gberthou/talabardine/board/board.brd

## EAGLE design board/board.brd (2021-04-22)

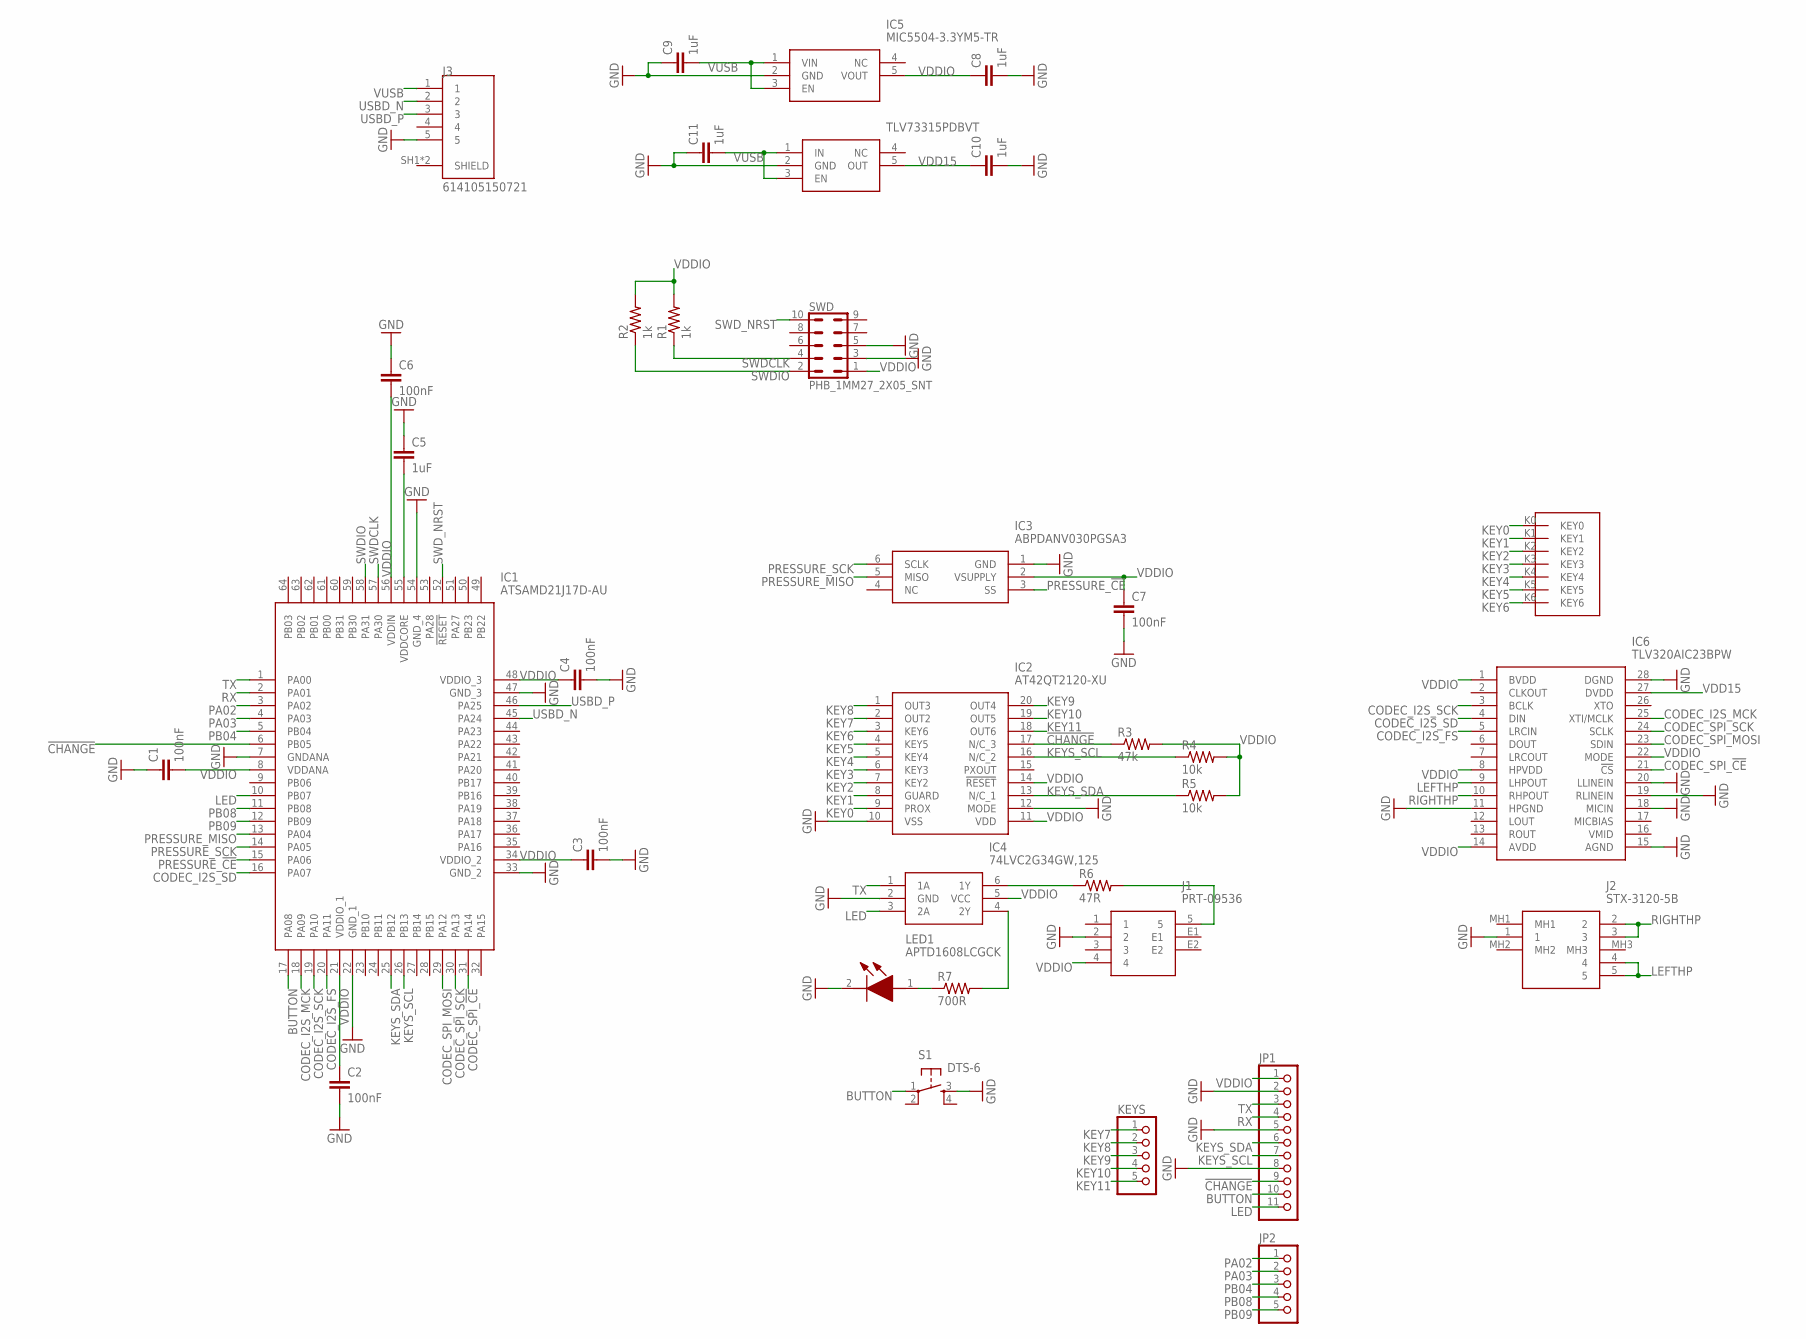
[picture p1: schematic board.sch]

Parts:
C1, C2, C3, C4, C6, C7: 100nF; C0603
C5, C8, C9, C10, C11: 1uF; C0603
IC1: ATSAMD21J17D-AU; QFP50P1200X1200X120-64N
IC2: AT42QT2120-XU; SOP65P638X120-20N
IC3: ABPDANV030PGSA3
IC4: 74LVC2G34GW,125; SOP65P210X110-6N
IC5: MIC5504-3.3YM5-TR; SOT95P280X145-5N
IC6: TLV320AIC23BPW; SOP65P640X120-28N
J1: PRT-09536; PRT09536
J2: STX-3120-5B; STX31205B
J3: 614105150721; WURTH_614105150721
JP1: PINHD-1X11; 1X11
JP2: PINHD-1X5; 1X05
KEYS: PINHD-1X5; 1X05
LED1: APTD1608LCGCK; APT1608CGCK
R1, R2: 1k; R0603
R3: 47k; R0603
R4, R5: 10k; R0603
R6: 47R; R0603
R7: 700R; R0603
S1: DTS-6
SWD: PHB_1MM27_2X05_SNT
TLV73315PDBVT: TLV73333PDBVT; SOT95P280X145-5N
U$1: KEYS

Connections:
!CHANGE!: IC1.6 (PB05), IC2.17 (N/C_3), JP1.9, R3.1
BUTTON: IC1.17 (PA08), JP1.10, S1.1
CODEC_I2S_FS: IC1.20 (PA11), IC6.5 (LRCIN)
CODEC_I2S_MCK: IC1.18 (PA09), IC6.25 (XTI/MCLK)
CODEC_I2S_SCK: IC1.19 (PA10), IC6.3 (BCLK)
CODEC_I2S_SD: IC1.16 (PA07), IC6.4 (DIN)
CODEC_SPI_!CE!: IC1.31 (PA14), IC6.21 (!CS)
CODEC_SPI_MOSI: IC1.29 (PA12), IC6.23 (SDIN)
CODEC_SPI_SCK: IC1.30 (PA13), IC6.24 (SCLK)
GND: C1.1, C2.2, C3.2, C4.2, C5.1, C6.1, C7.2, C8.2, C9.1, C10.2, C11.1, IC1.7 (GNDANA), IC1.22 (GND_1), IC1.33 (GND_2), IC1.47 (GND_3), IC1.54 (GND_4), IC2.10 (VSS), IC2.12 (MODE), IC3.1 (GND), IC4.2 (GND), IC5.2 (GND), IC6.11 (HPGND), IC6.15 (AGND), IC6.18 (MICIN), IC6.19 (RLINEIN), IC6.20 (LLINEIN), IC6.28 (DGND), J1.2, J2.1, J3.5, JP1.2, JP1.5, JP1.8, LED1.2 (K), S1.3, SWD.3, SWD.5, TLV73315PDBVT.2 (GND)
KEY0: IC2.9 (PROX), U$1.K0 (KEY0)
KEY1: IC2.8 (GUARD), U$1.K1 (KEY1)
KEY2: IC2.7 (KEY2), U$1.K2 (KEY2)
KEY3: IC2.6 (KEY3), U$1.K3 (KEY3)
KEY4: IC2.5 (KEY4), U$1.K4 (KEY4)
KEY5: IC2.4 (KEY5), U$1.K5 (KEY5)
KEY6: IC2.3 (KEY6), U$1.K6 (KEY6)
KEY7: IC2.2 (OUT2), KEYS.1
KEY8: IC2.1 (OUT3), KEYS.2
KEY9: IC2.20 (OUT4), KEYS.3
KEY10: IC2.19 (OUT5), KEYS.4
KEY11: IC2.18 (OUT6), KEYS.5
KEYS_SCL: IC1.26 (PB13), IC2.16 (N/C_2), JP1.7, R4.1
KEYS_SDA: IC1.25 (PB12), IC2.13 (N/C_1), JP1.6, R5.1
LED: IC1.10 (PB07), IC4.3 (2A), JP1.11
LEFTHP: IC6.9 (LHPOUT), J2.4, J2.5
unnamed: IC4.4 (2Y), R7.2
unnamed: J1.5, R6.2
unnamed: C5.2, IC1.55 (VDDCORE)
unnamed: LED1.1 (A), R7.1
unnamed: IC4.6 (1Y), R6.1
PA02: IC1.3 (PA02), JP2.1
PA03: IC1.4 (PA03), JP2.2
PB04: IC1.5 (PB04), JP2.3
PB08: IC1.11 (PB08), JP2.4
PB09: IC1.12 (PB09), JP2.5
PRESSURE_!CE!: IC1.15 (PA06), IC3.3 (SS)
PRESSURE_MISO: IC1.13 (PA04), IC3.5 (MISO)
PRESSURE_SCK: IC1.14 (PA05), IC3.6 (SCLK)
RIGHTHP: IC6.10 (RHPOUT), J2.2, J2.3
RX: IC1.2 (PA01), JP1.4
SWDCLK: IC1.57 (PA30), R1.1, SWD.4
SWDIO: IC1.58 (PA31), R2.1, SWD.2
SWD_NRST: IC1.52 (!RESET), SWD.10
TX: IC1.1 (PA00), IC4.1 (1A), JP1.3
USBD_N: IC1.45 (PA24), J3.2
USBD_P: IC1.46 (PA25), J3.3
VDD15: C10.1, IC6.27 (DVDD), TLV73315PDBVT.5 (OUT)
VDDIO: C1.2, C2.1, C3.1, C4.1, C6.2, C7.1, C8.1, IC1.8 (VDDANA), IC1.21 (VDDIO_1), IC1.34 (VDDIO_2), IC1.48 (VDDIO_3), IC1.56 (VDDIN), IC2.11 (VDD), IC2.14 (!RESET), IC3.2 (VSUPPLY), IC4.5 (VCC), IC5.5 (VOUT), IC6.1 (BVDD), IC6.8 (HPVDD), IC6.14 (AVDD), IC6.22 (MODE), J1.4, JP1.1, R1.2, R2.2, R3.2, R4.2, R5.2, SWD.1
VUSB: C9.2, C11.2, IC5.1 (VIN), IC5.3 (EN), J3.1, TLV73315PDBVT.1 (IN), TLV73315PDBVT.3 (EN)

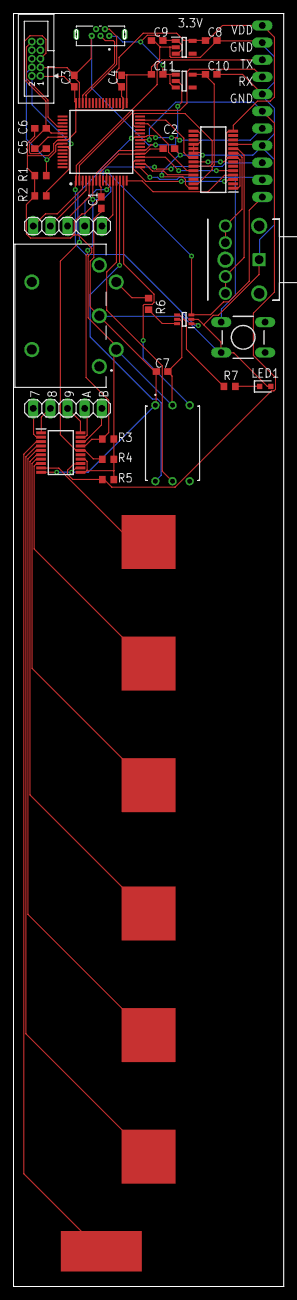
[picture p2: board board.brd from above]

Board: 2 copper layers, 40.0 x 188.5 mm, 35 parts (1 on the bottom side), 50 nets.
