gberthou/talabardine/(commit log)

2021-04-22 First version, UART and I2C support
    [board.brd, board.sch, bom.csv]
2021-04-22 Basic driver for ATQT2120
2021-04-24 Basic driver for ABP series pressure sensor
2021-04-24 Improved key sensor sensitivity and reactivity
2021-04-25 Interrupt-based key detection
2021-04-26 Timer-based interrupts (TC)
2021-12-01 Simple USB driver capable of sending descriptors and reacting upon receiving SET_CONFIGURATION messages
2021-12-15 USB MIDI 1.00 + Compatibility with arm-none-eabi-gcc 6.3.1
2021-12-18 Interrupt-based I2C driver + fixed ATQT2120 driver
    [atqt2120.c, atqt2120.h, nvic.h, sercom.c, sercom.h, talabardine.c, udc.c]
2021-12-19 Integration with USB driver + Fixed ATQT2120 driver
    [atqt2120.c, talabardine.c, udc.c, udc.h, usb.c]
2021-12-20 Protocol- and talabardine-specific USB drivers are now separate
